fuzzyers/Droid/photos&vids/printing body.jpg

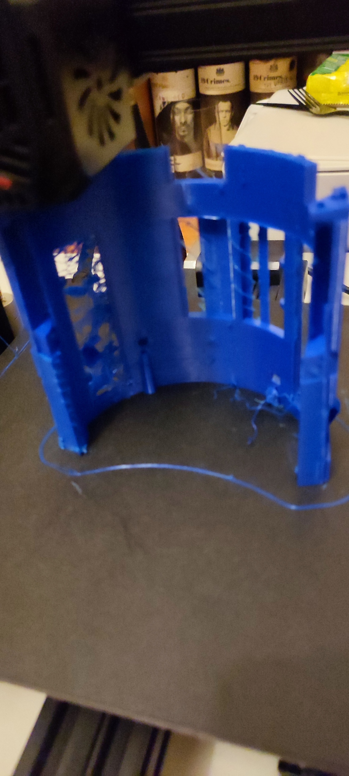
photos&vids/printing body.jpg
