fuzzyers/Droid/photos&vids/HeadTurningSetup.jpg

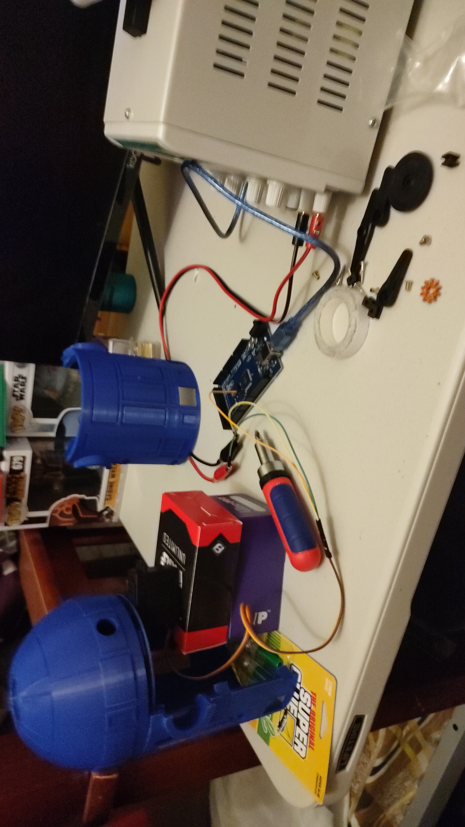
photos&vids/HeadTurningSetup.jpg
