fuzzyers/Droid/README.md

# Droid
Building an Atonmous rolling droid

Extra videos that couldnt upload to github
[https://drive.google.com/drive/u/0/folders/1LiQj8qATu0QSJ6sYIhgVQADvBBUaWfd3
](https://drive.google.com/drive/folders/1LiQj8qATu0QSJ6sYIhgVQADvBBUaWfd3?usp=sharing)
