fuzzyers/Droid/Controller/bottle.jpg

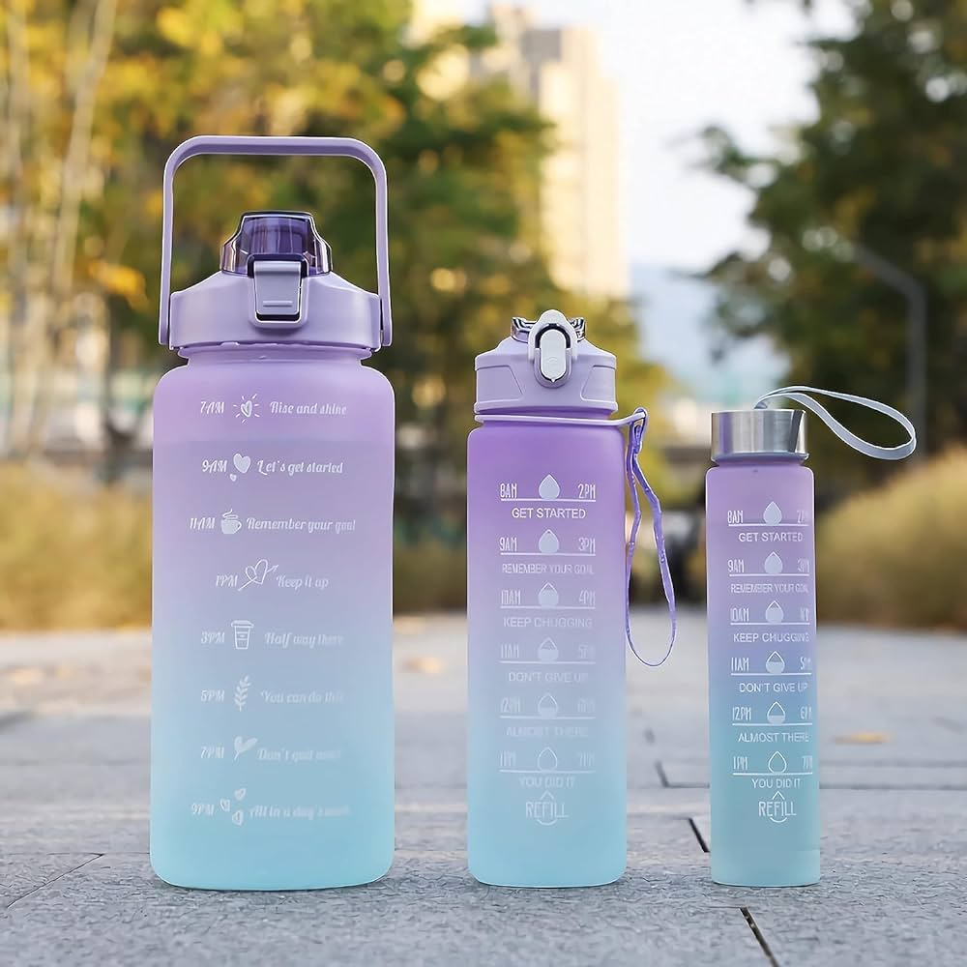
Controller/bottle.jpg
