fuzzyers/Droid/Controller/brad.jpg

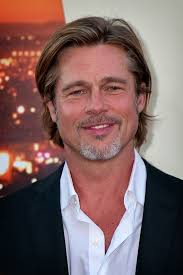
Controller/brad.jpg
