fuzzyers/Droid/Controller/captured_image.jpg

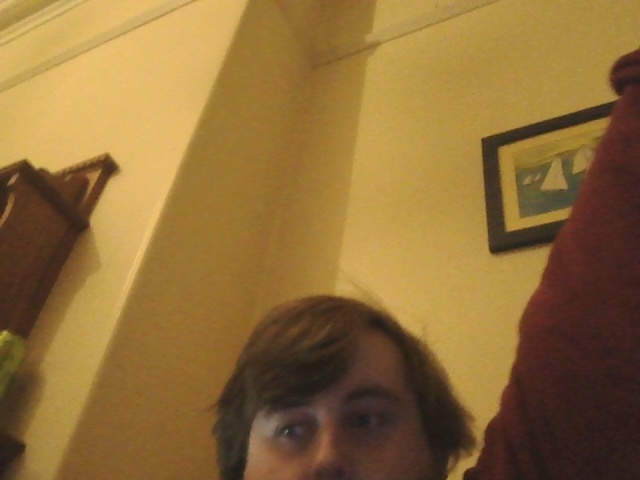
Controller/captured_image.jpg
