fuzzyers/Droid/Controller/depth_map.png

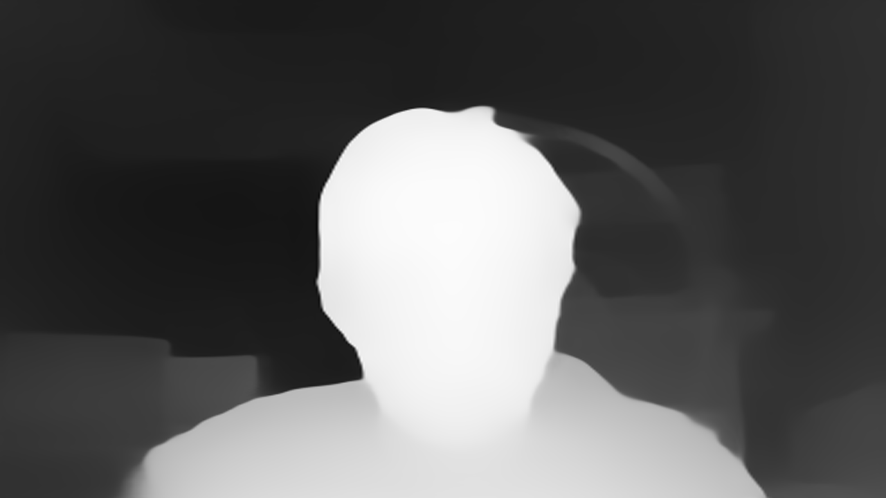
Controller/depth_map.png
