fuzzyers/Droid/Controller/FacialRecognition/me2.jpg

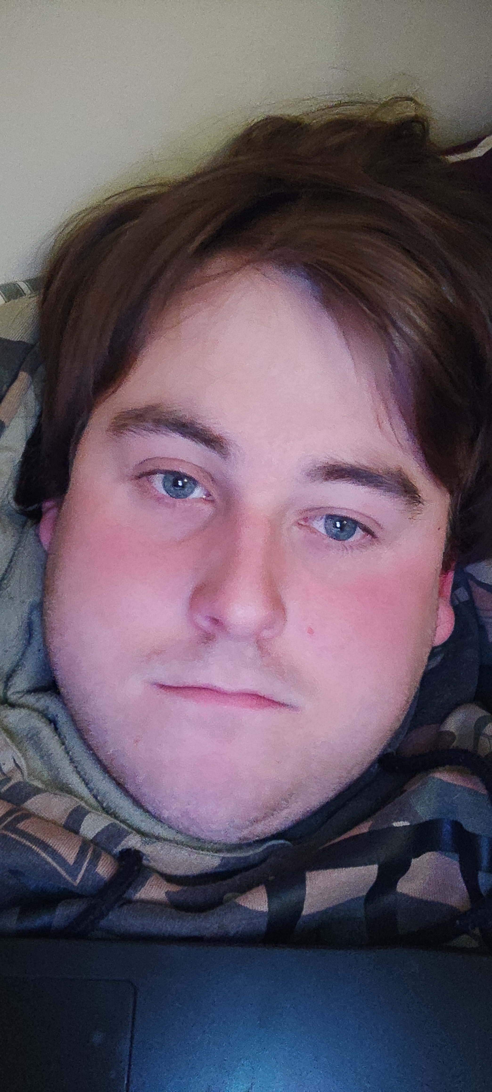
Controller/FacialRecognition/me2.jpg
