fuzzyers/Droid/Controller/FacialRecognition/me3.jpg

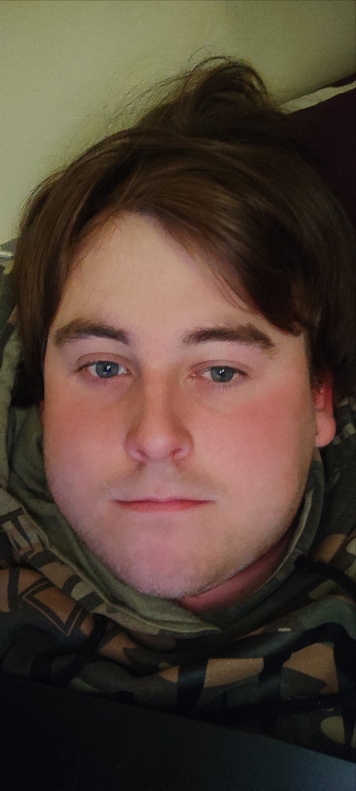
Controller/FacialRecognition/me3.jpg
