fuzzyers/Droid/Controller/FacialRecognition/me4.jpg

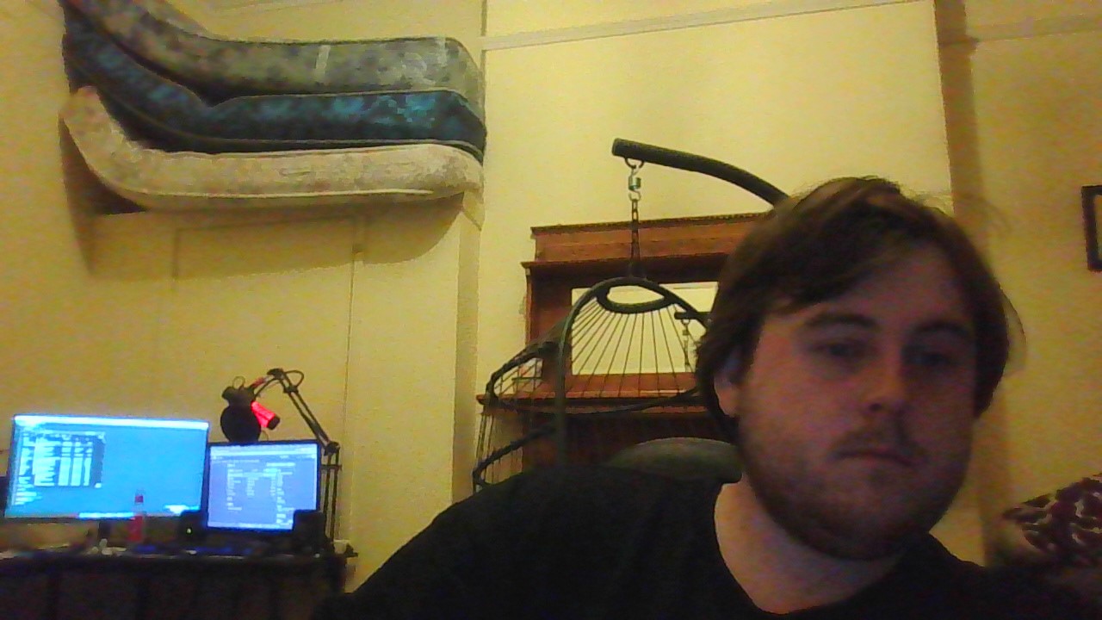
Controller/FacialRecognition/me4.jpg
