fuzzyers/Droid/Controller/FacialRecognition/me5.jpg

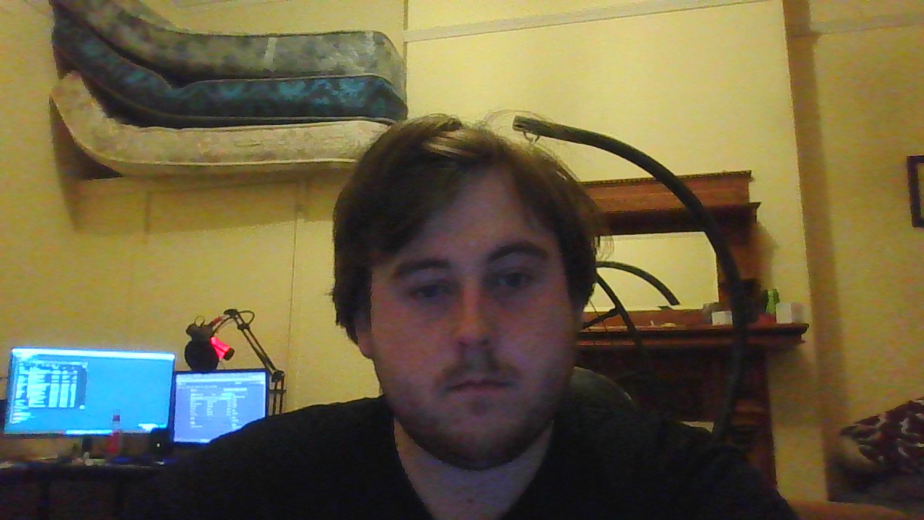
Controller/FacialRecognition/me5.jpg
