fuzzyers/Droid/Controller/FacialRecognition/me6.jpg

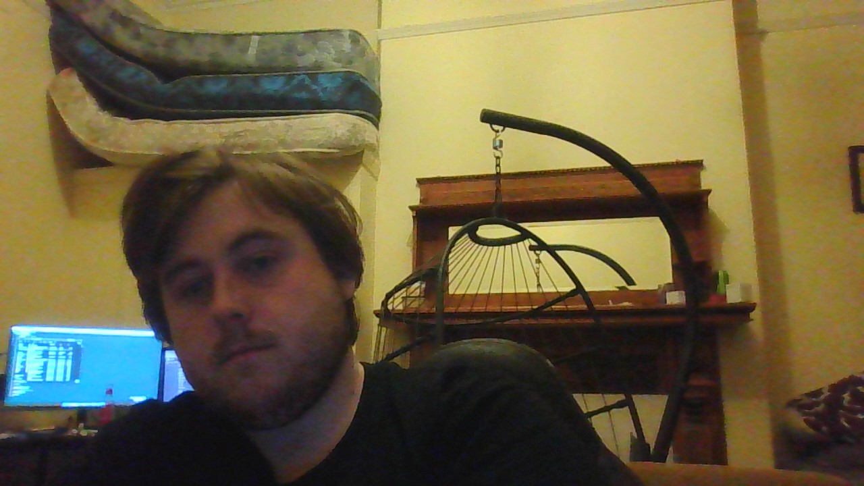
Controller/FacialRecognition/me6.jpg
