fuzzyers/Droid/Controller/group.jpg

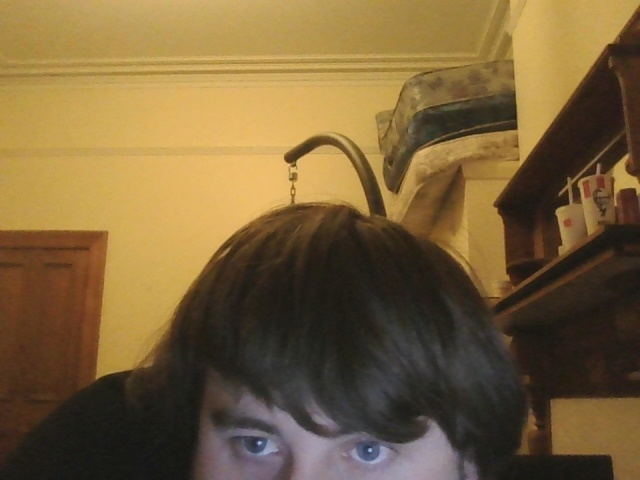
Controller/group.jpg
