fuzzyers/Droid/Controller/me3.jpg

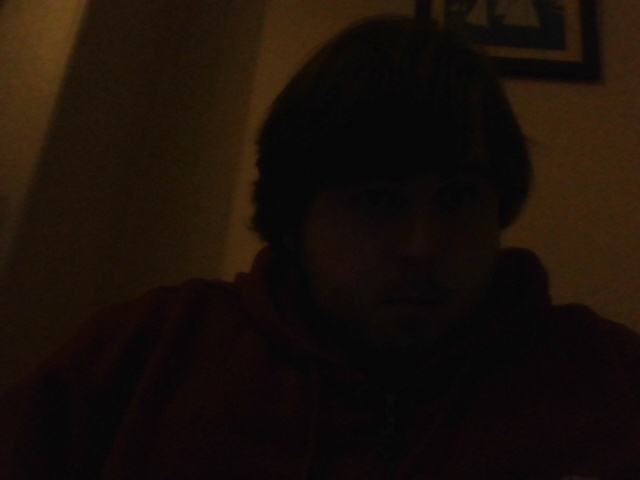
Controller/me3.jpg
