fuzzyers/Droid/Controller/ObjectDetection.png

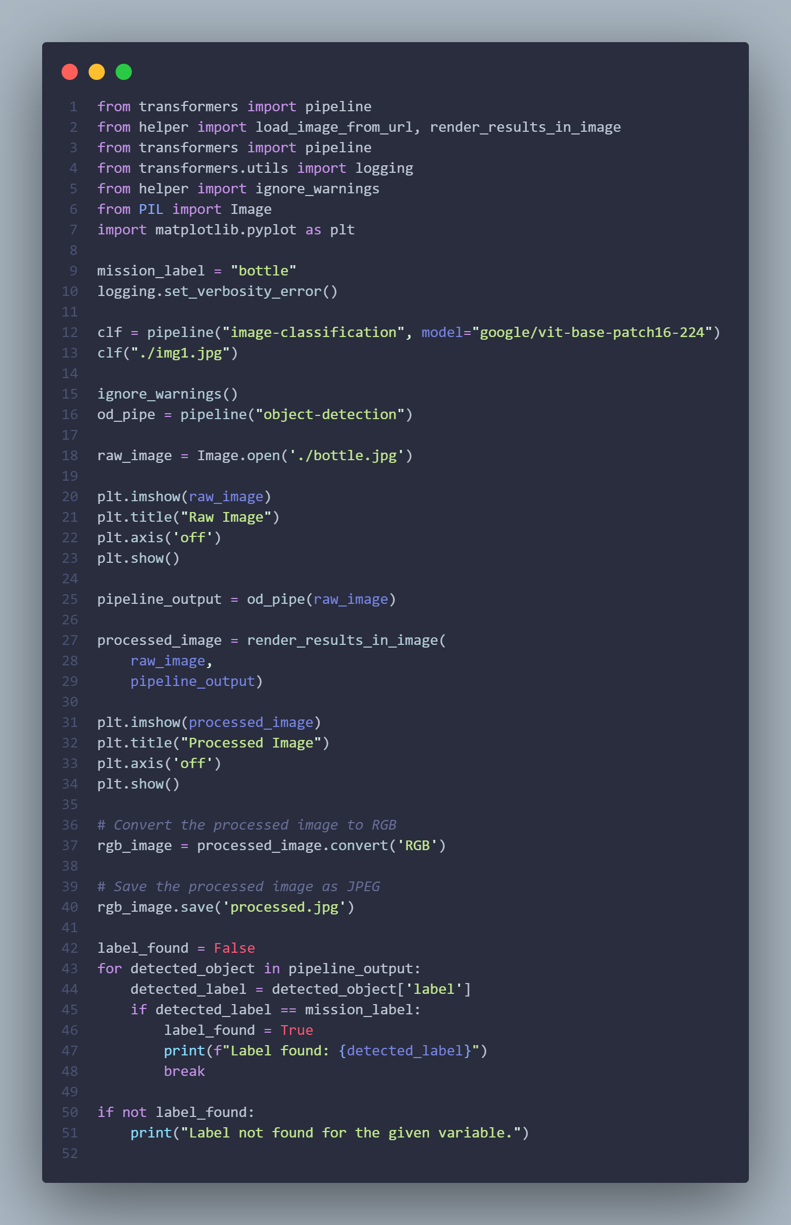
Controller/ObjectDetection.png
