fuzzyers/Droid/Controller/processed.jpg

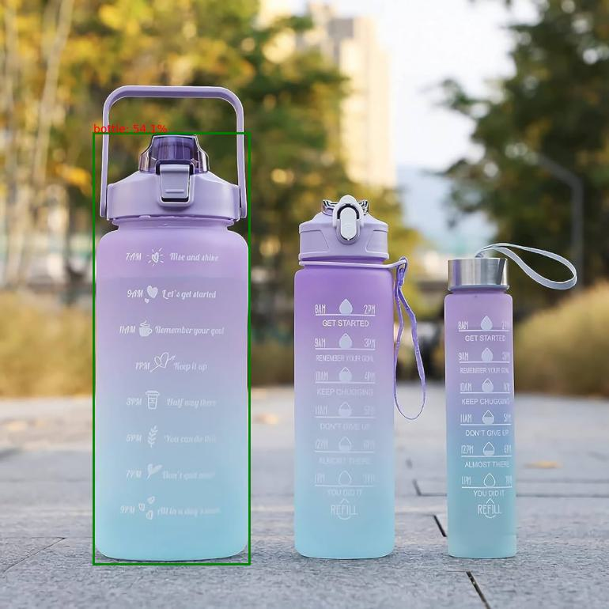
Controller/processed.jpg
