fuzzyers/Droid/Controller/refrence.jpg

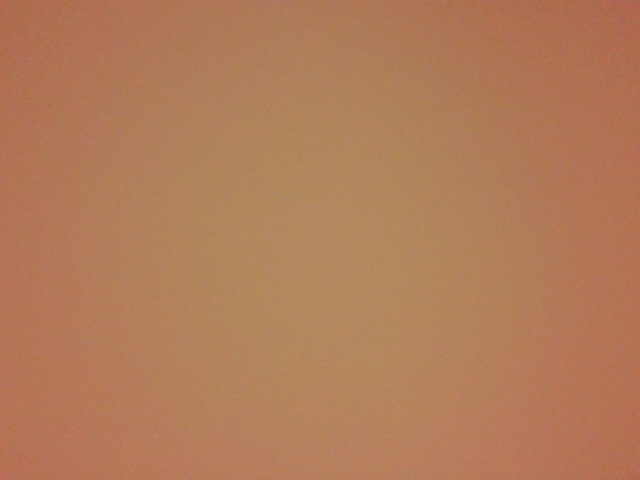
Controller/refrence.jpg
