fuzzyers/Droid/DepthMap/baldwin-street-dunedin.jpg.webp

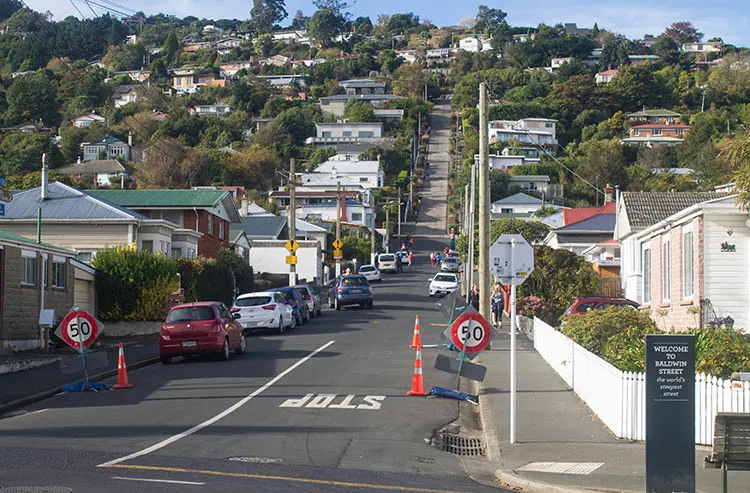
DepthMap/baldwin-street-dunedin.jpg.webp
