fuzzyers/Droid/DepthMap/bolt.jpg

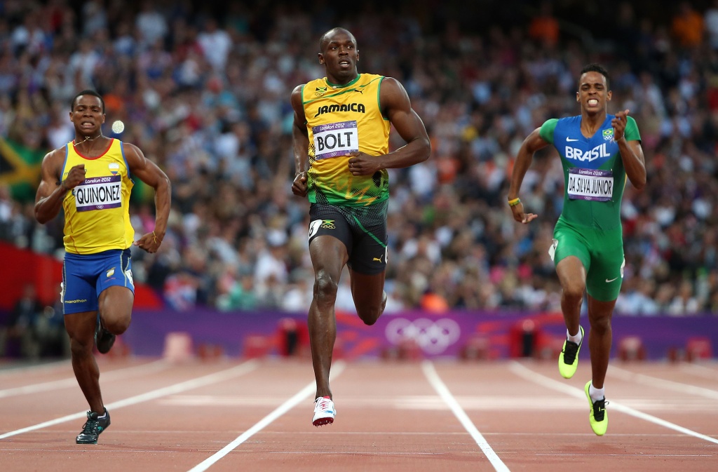
DepthMap/bolt.jpg
