fuzzyers/Droid/DepthMap/depth_map.png

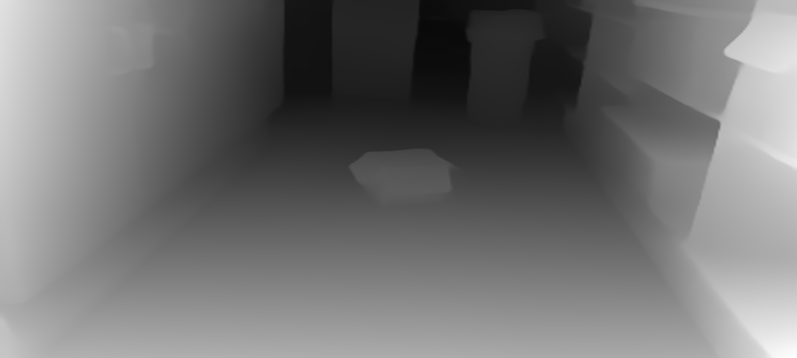
DepthMap/depth_map.png
