fuzzyers/Droid/DepthMap/img2.jpg

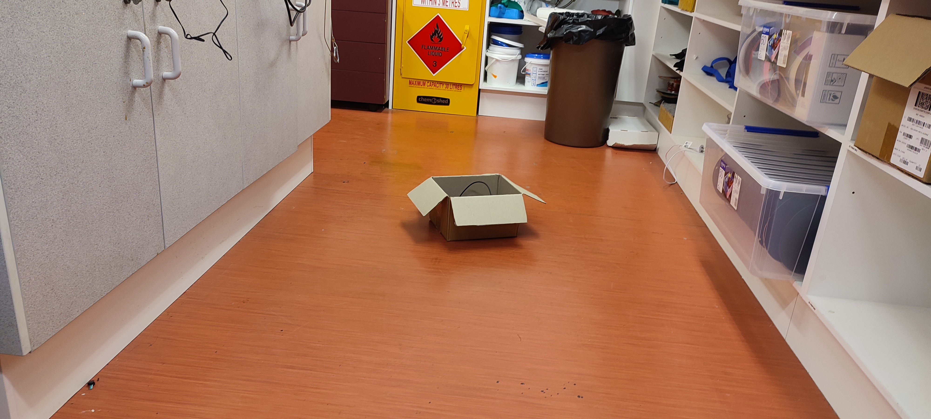
DepthMap/img2.jpg
