fuzzyers/Droid/DepthMap/img3.jpg

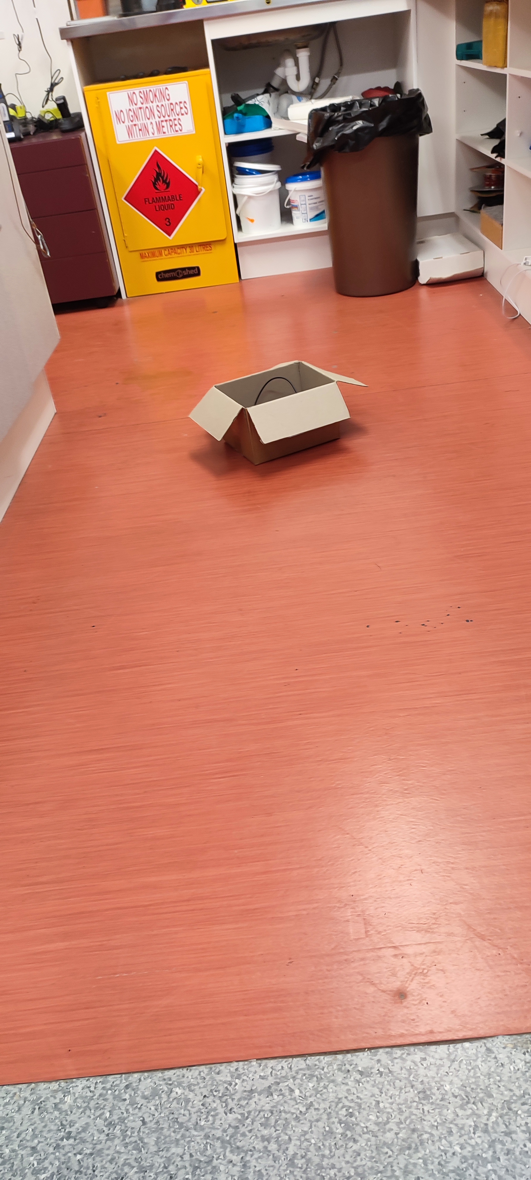
DepthMap/img3.jpg
