fuzzyers/Droid/photos&vids/1719391815629.jpg

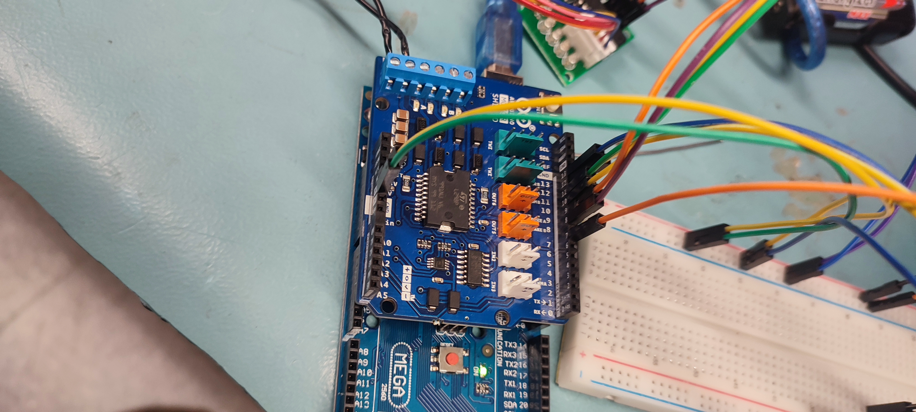
photos&vids/1719391815629.jpg
