fuzzyers/Droid/photos&vids/1719391815665.jpg

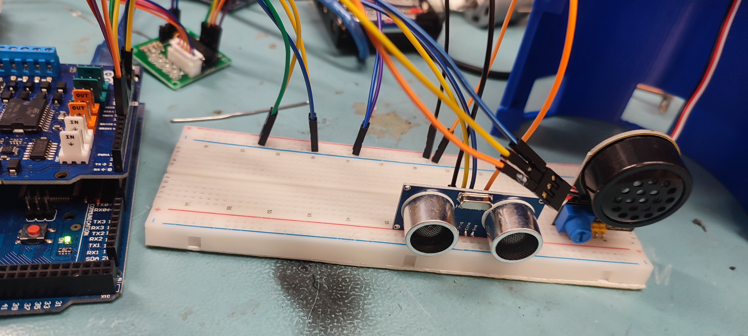
photos&vids/1719391815665.jpg
