fuzzyers/Droid/photos&vids/1719391815684.jpg

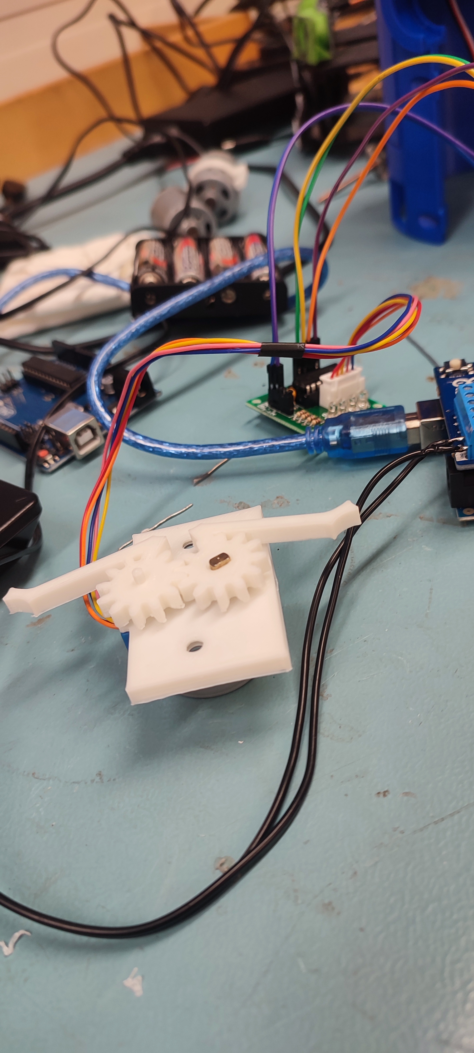
photos&vids/1719391815684.jpg
