fuzzyers/Droid/photos&vids/arduino1.png

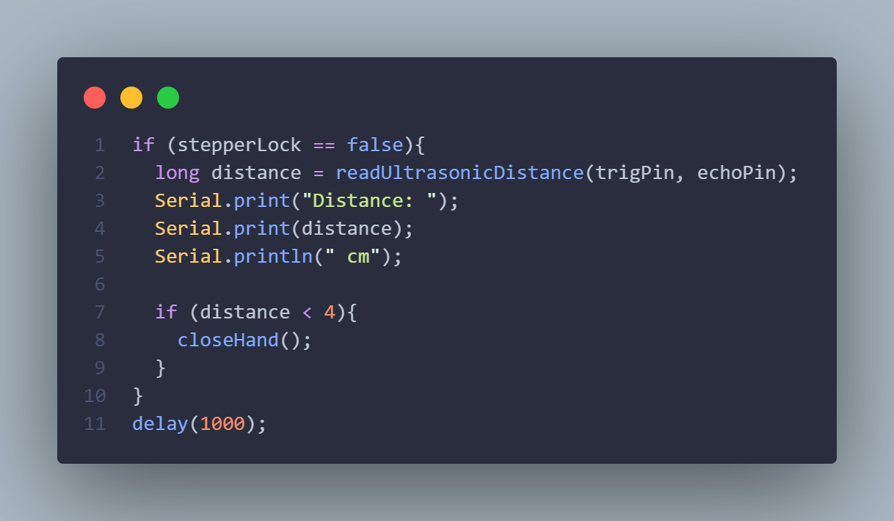
photos&vids/arduino1.png
