fuzzyers/Droid/photos&vids/arduino2.png

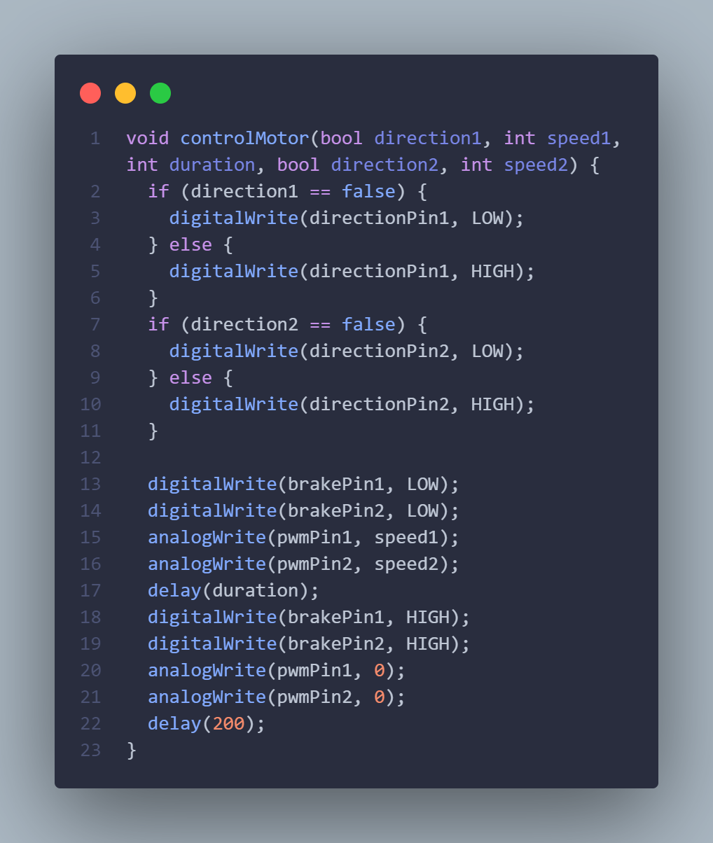
photos&vids/arduino2.png
