fuzzyers/Droid/photos&vids/BodyWithoutHead.jpg

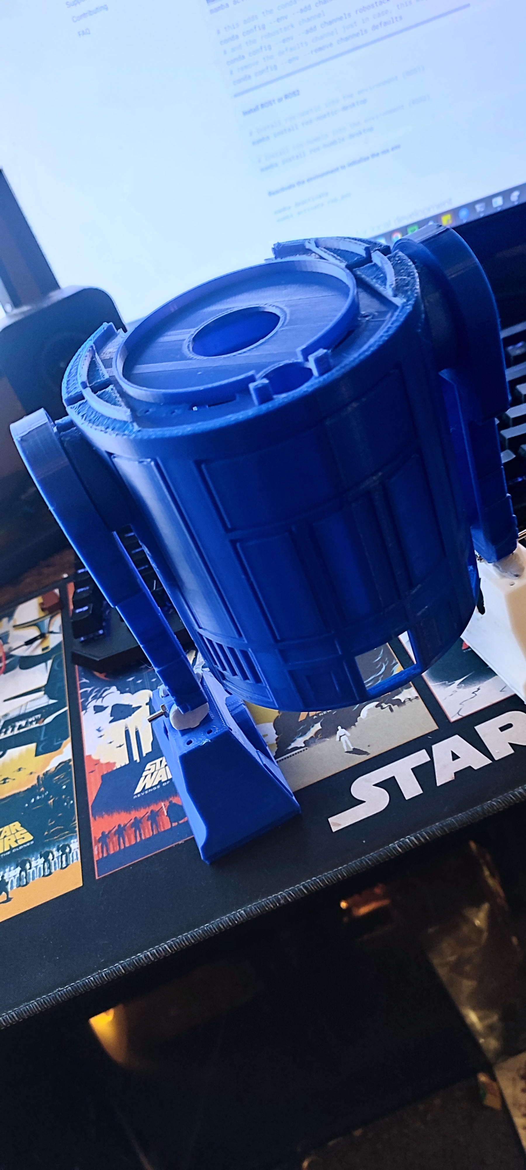
photos&vids/BodyWithoutHead.jpg
