fuzzyers/Droid/photos&vids/ControllerDiagram.jpg

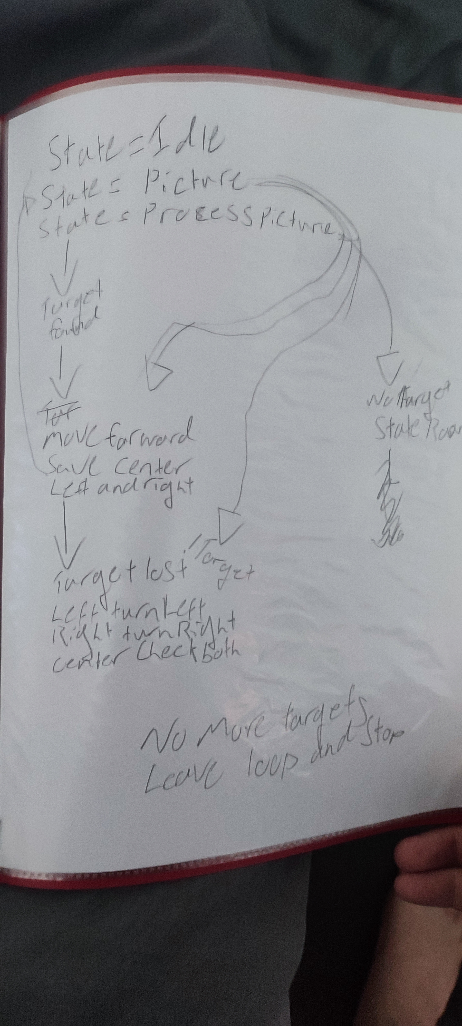
photos&vids/ControllerDiagram.jpg
