fuzzyers/Droid/photos&vids/Hand2.jpg

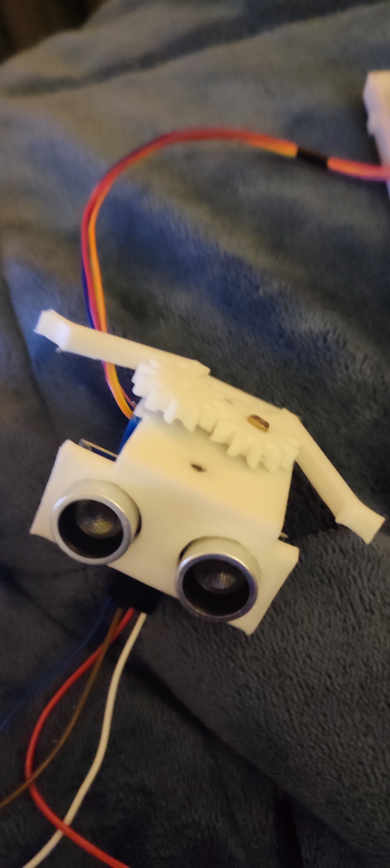
photos&vids/Hand2.jpg
