fuzzyers/Droid/photos&vids/HeadShotsFromFaceialRecognitionAttemptOne.jpg

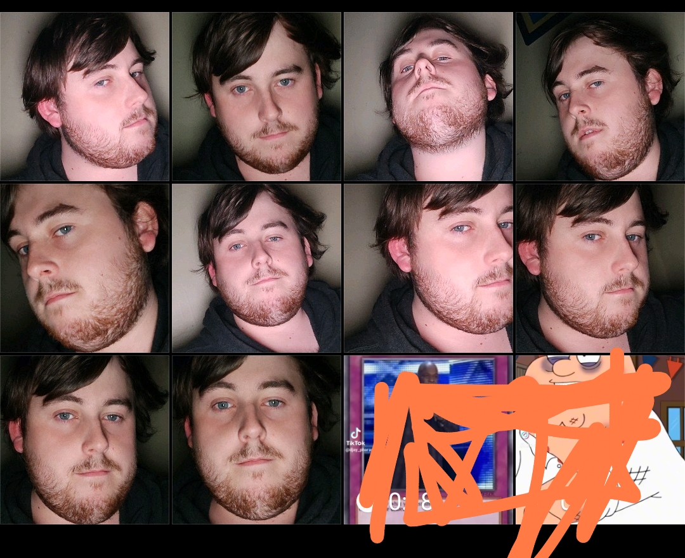
photos&vids/HeadShotsFromFaceialRecognitionAttemptOne.jpg
