fuzzyers/Droid/photos&vids/Ideas.jpg

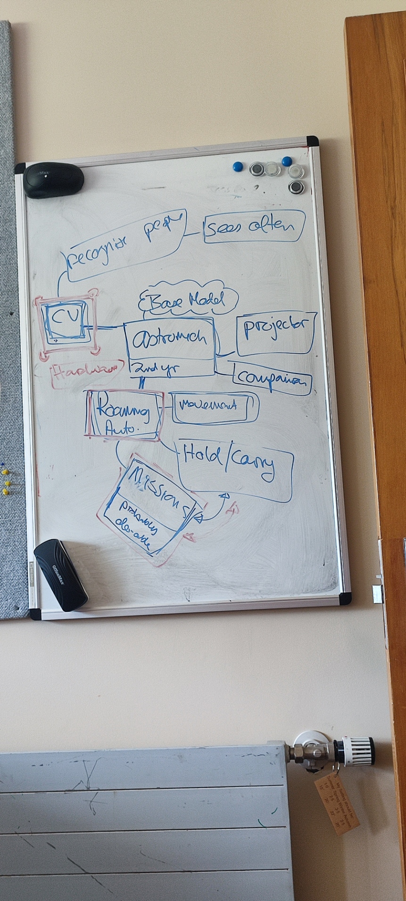
photos&vids/Ideas.jpg
