fuzzyers/Droid/photos&vids/ObjectDetection1.png

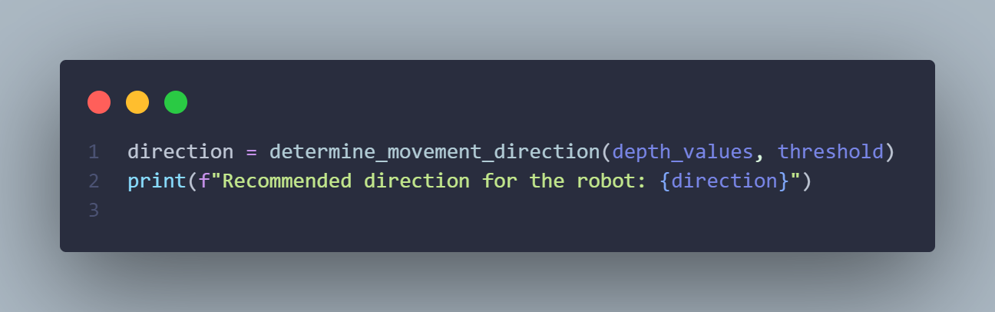
photos&vids/ObjectDetection1.png
