fuzzyers/Droid/photos&vids/WheelV1.jpg

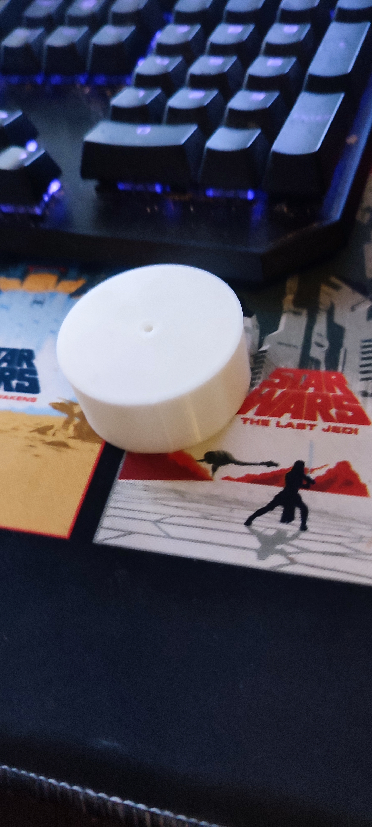
photos&vids/WheelV1.jpg
