fuzzyers/Droid/TensorFlowDetection/img1.jpg

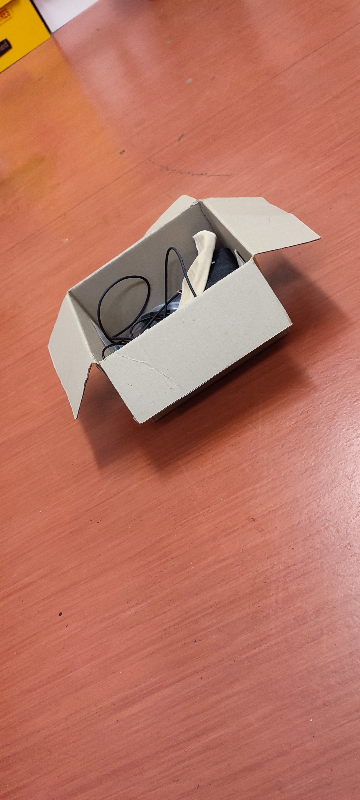
TensorFlowDetection/img1.jpg
