fuzzyers/Droid/TensorFlowDetection/IMG_20240605_111805.jpg

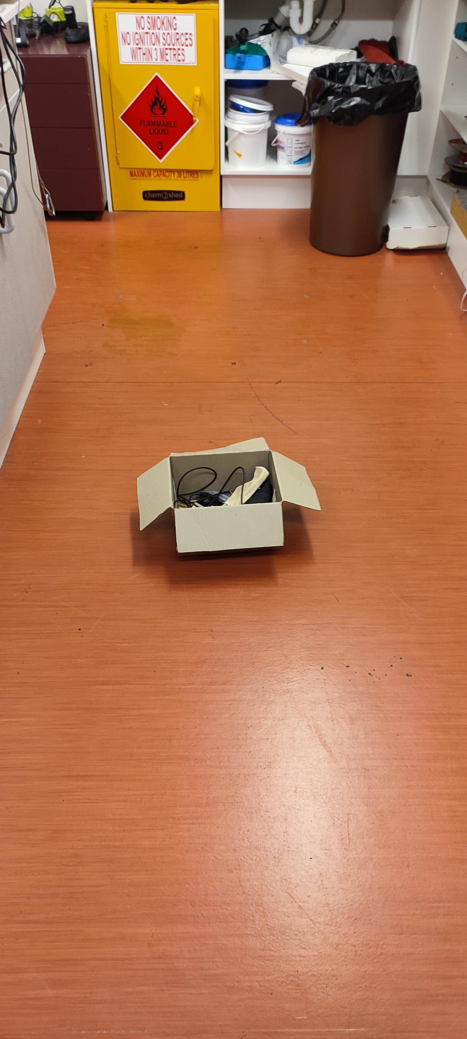
TensorFlowDetection/IMG_20240605_111805.jpg
