fuzzyers/Droid/TensorFlowDetection/IMG_20240605_111808.jpg

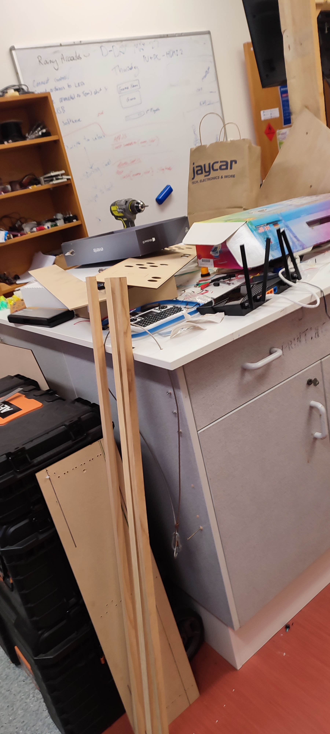
TensorFlowDetection/IMG_20240605_111808.jpg
