fuzzyers/Droid/TensorFlowDetection/me.jpg

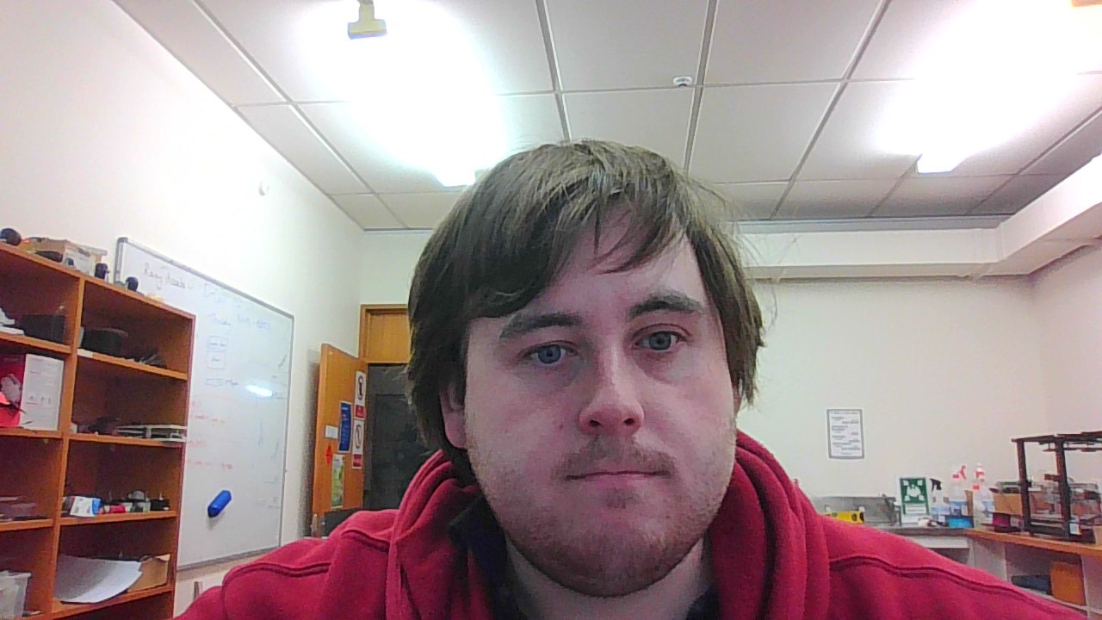
TensorFlowDetection/me.jpg
