fuzzyers/Droid/r2model/dome_projector_grey.stl

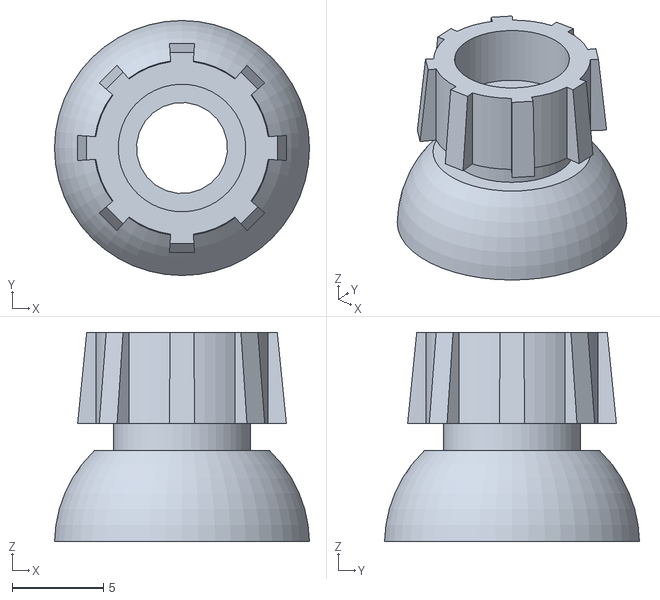
[picture p71: CAD file, 2024-06-11]
r2model/dome_projector_grey.stl
14.0 x 14.0 x 11.5
