fuzzyers/Droid/r2model/gearbox_2.stl

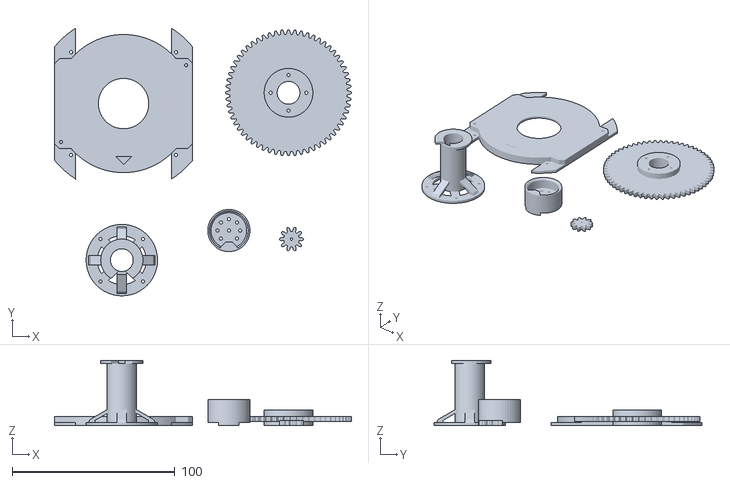
[picture p72: CAD file, 2024-06-11]
r2model/gearbox_2.stl
182.8 x 164.8 x 40.0
