fuzzyers/Droid/r2model/body_parts_blue.stl

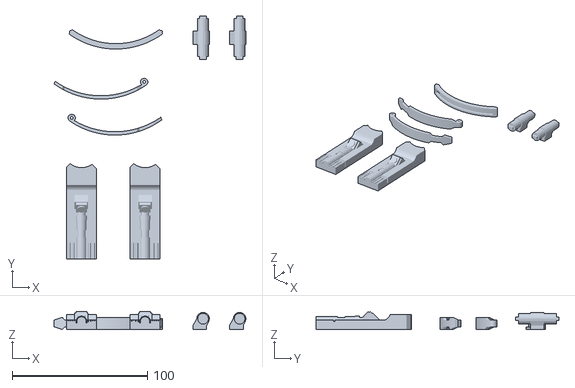
[picture p73: CAD file, 2024-06-11]
r2model/body_parts_blue.stl
141.9 x 179.6 x 13.4
