fuzzyers/Droid/r2model/leg_left_white.stl

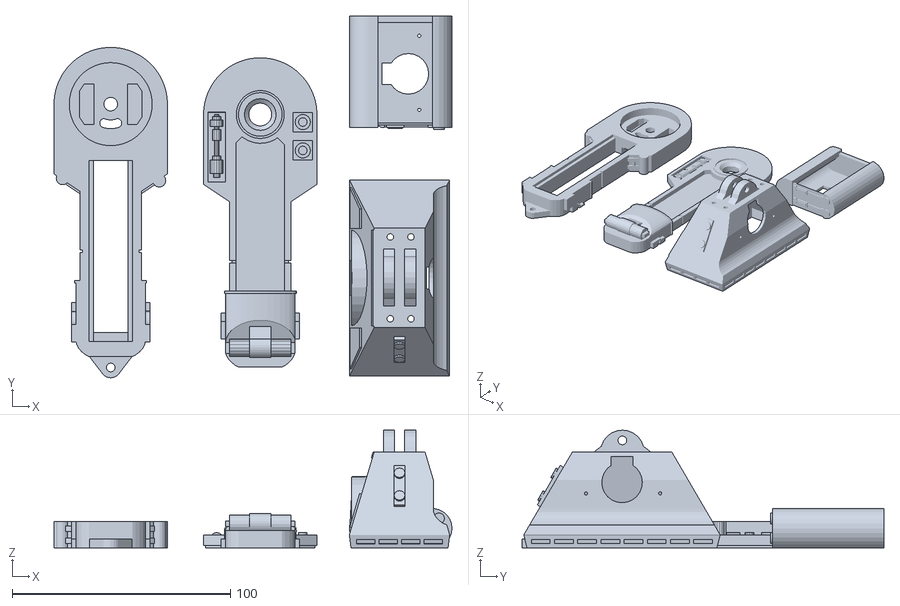
[picture p74: CAD file, 2024-06-11]
r2model/leg_left_white.stl
182.5 x 165.8 x 54.0
