fuzzyers/Droid/r2model/body_utilityarm_blue.stl

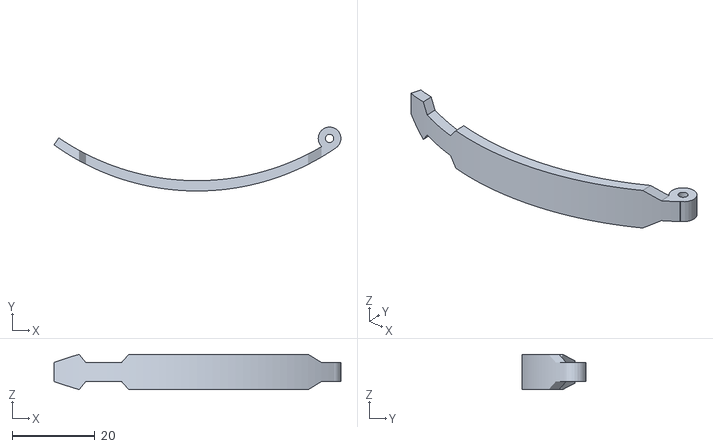
[picture p75: CAD file, 2024-06-11]
r2model/body_utilityarm_blue.stl
69.2 x 15.4 x 8.50
