fuzzyers/Droid/r2model/body_parts_white.stl

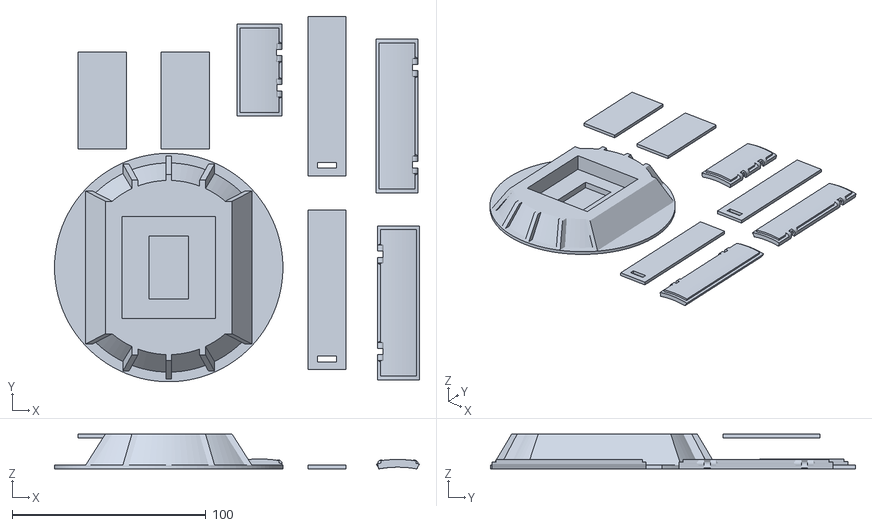
[picture p76: CAD file, 2024-06-11]
r2model/body_parts_white.stl
188.5 x 188.8 x 18.0
