fuzzyers/Droid/r2model/body_white.stl

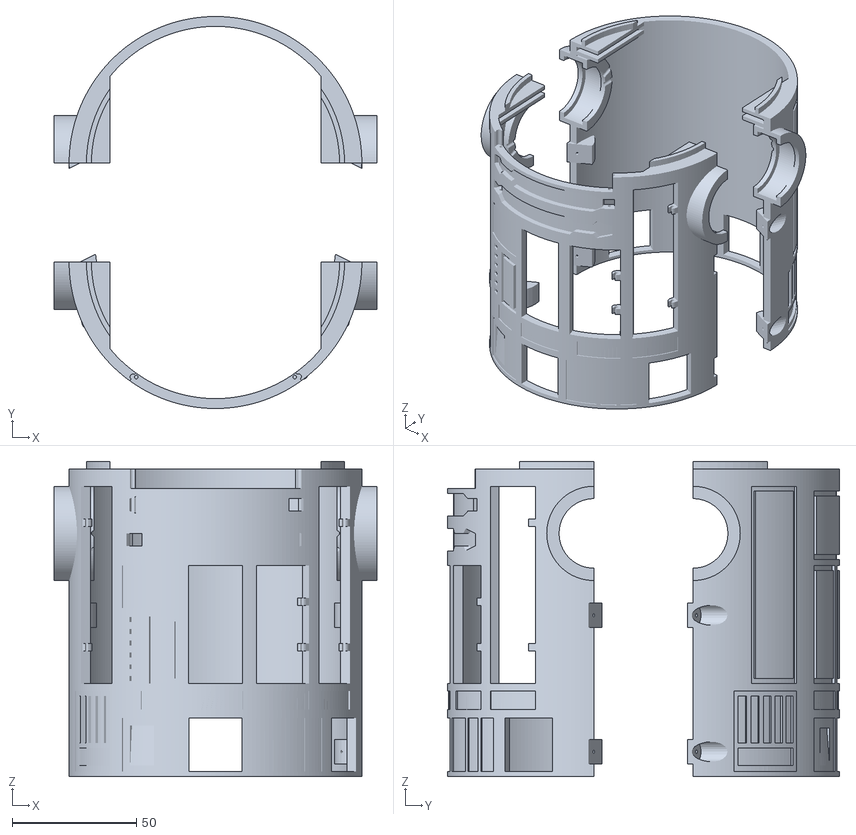
[picture p77: CAD file, 2024-06-11]
r2model/body_white.stl
130.0 x 158.0 x 127.0
