fuzzyers/Droid/r2model/dome_bodyparts_grey.stl

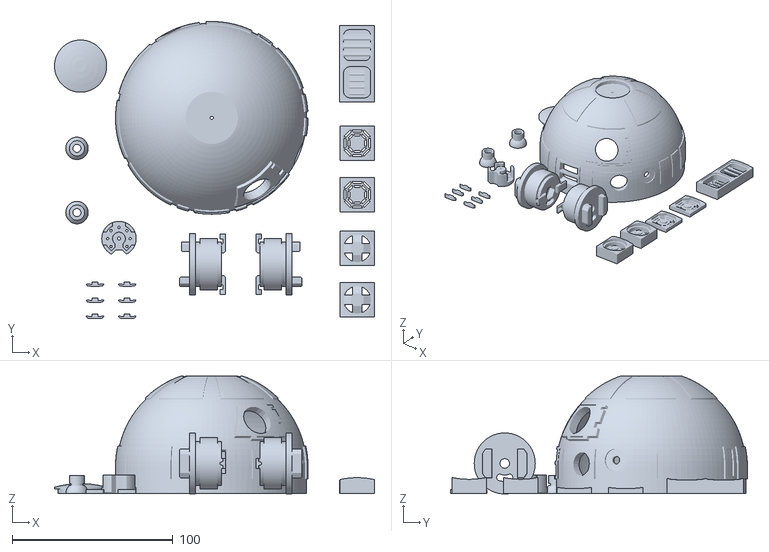
[picture p78: CAD file, 2024-06-11]
r2model/dome_bodyparts_grey.stl
199.2 x 184.9 x 73.4
