fuzzyers/Droid/r2model/r2d2_skirt_batt.stl

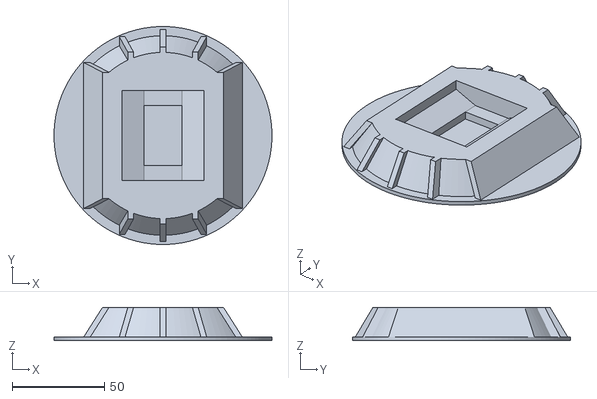
[picture p79: CAD file, 2024-06-11]
r2model/r2d2_skirt_batt.stl
118.0 x 118.0 x 18.0
