fuzzyers/Droid/r2model/r2d2_skirt.stl

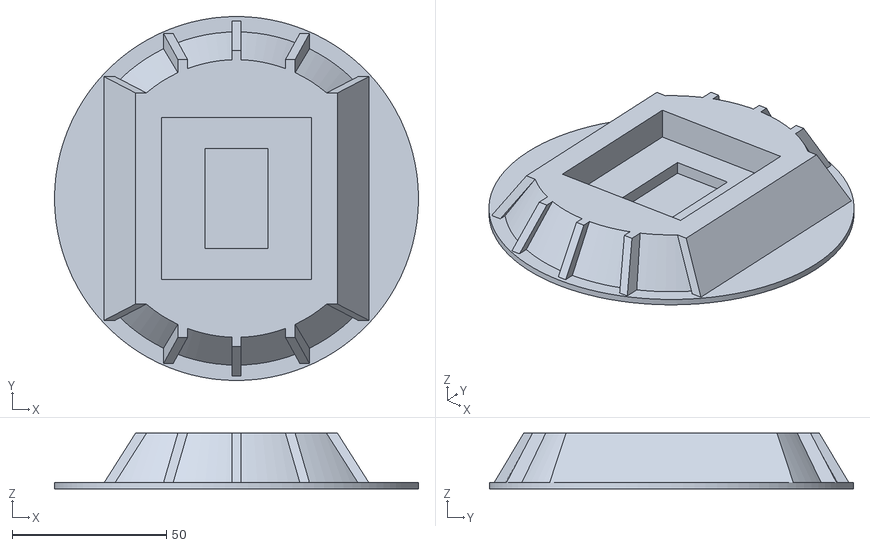
[picture p80: CAD file, 2024-06-11]
r2model/r2d2_skirt.stl
118.0 x 118.0 x 18.0
