fuzzyers/Droid/r2model/leg_right_white.stl

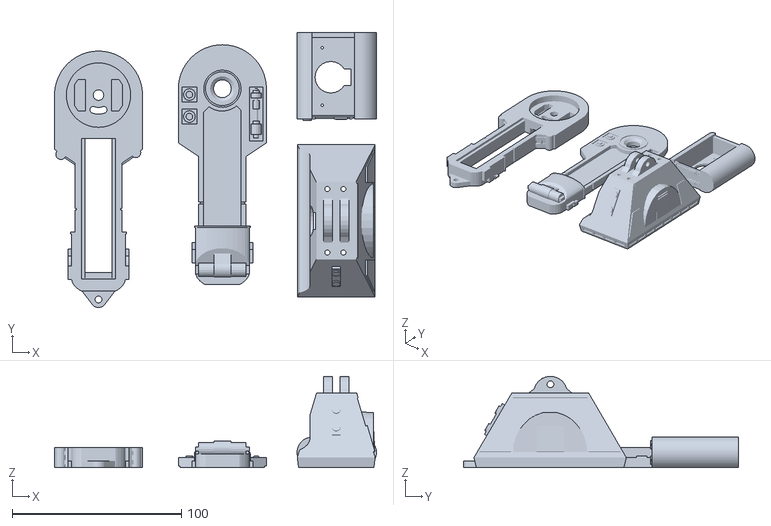
[picture p81: CAD file, 2024-06-11]
r2model/leg_right_white.stl
190.2 x 162.5 x 54.0
