fuzzyers/Droid/r2model/gearbox_1.stl

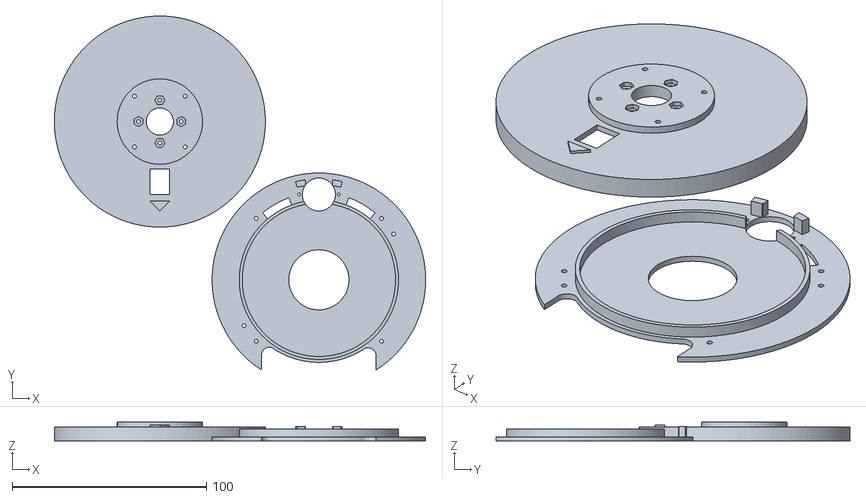
[picture p82: CAD file, 2024-06-11]
r2model/gearbox_1.stl
191.3 x 182.3 x 9.60
