fuzzyers/Droid/photos&vids/Echo Sensor Testing Wiring.jpg

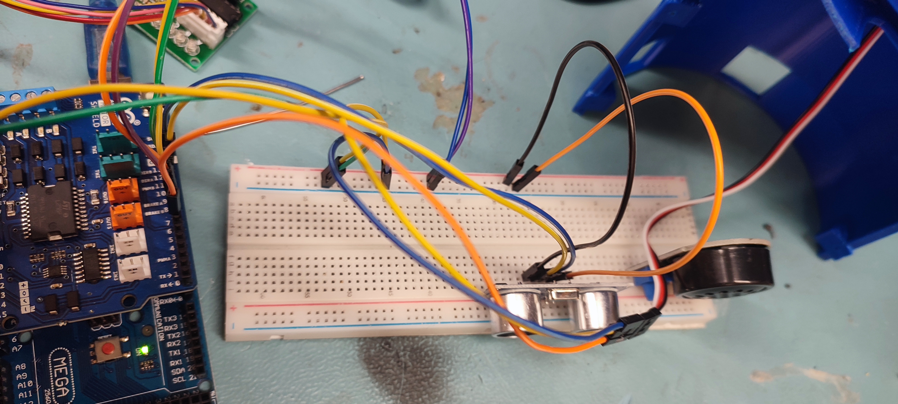
photos&vids/Echo Sensor Testing Wiring.jpg
