fuzzyers/Droid/photos&vids/Installing Packages on Pi.jpg

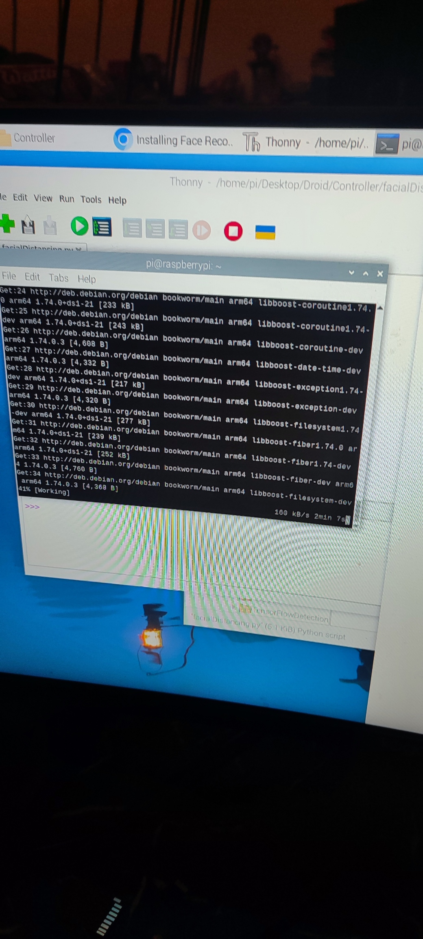
photos&vids/Installing Packages on Pi.jpg
