fuzzyers/Droid/photos&vids/Raspberry Pi Package indvidual Package installation for DLIB Library.jpg

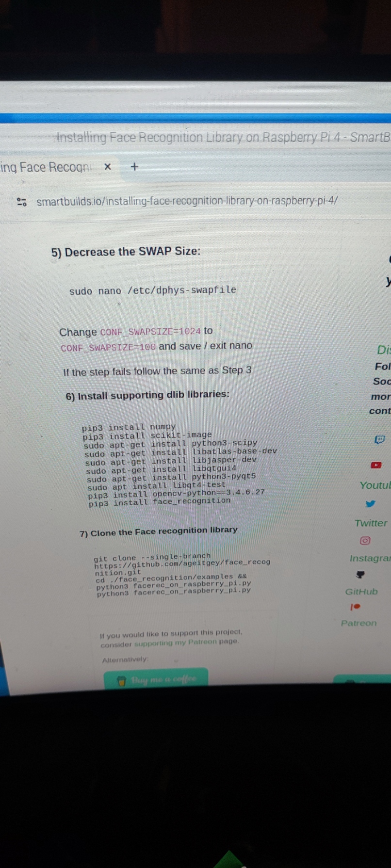
photos&vids/Raspberry Pi Package indvidual Package installation for DLIB Library.jpg
