fuzzyers/Droid/photos&vids/Raspberry Pi Package indvidual Package installation for FaceRcognition Library.jpg

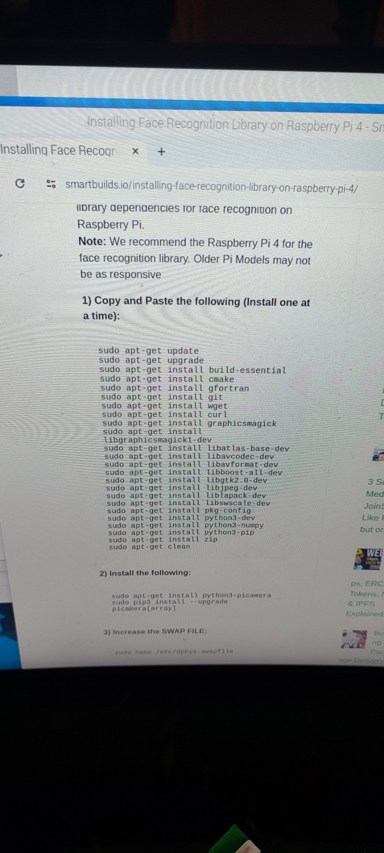
photos&vids/Raspberry Pi Package indvidual Package installation for FaceRcognition Library.jpg
