fuzzyers/Droid/photos&vids/testing on raspberry pi.jpg

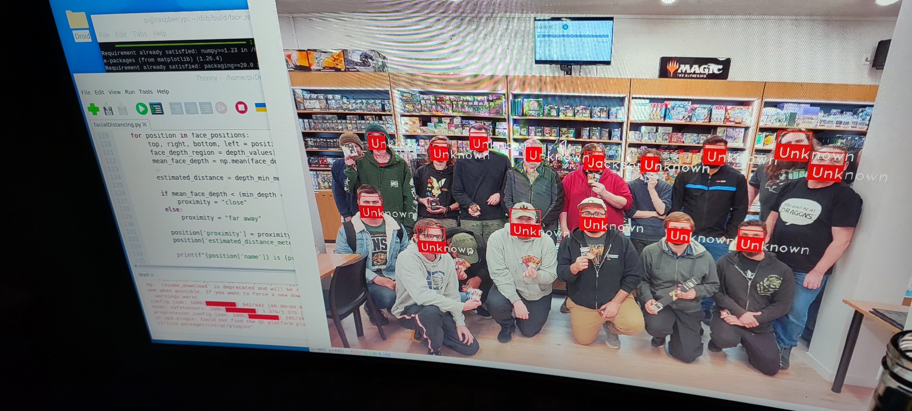
photos&vids/testing on raspberry pi.jpg
