fuzzyers/Droid/(threads)

Thread 3 (2024-03-12):

Computer Vision [Obstacles]

fuzzyers, 2024-03-12:
The main sensor of the robot to help it see its way round will be a camera such as a pi camera.
Using computer vision it will be trained to recognise obstacles and to avoid them.

Thread 5 (2024-06-12):

Controller

fuzzyers, 2024-06-12:
- The controllers current state is it reads and sends serial to an arduino.
- It currently takes a snap with the webcam
- It will execute the facial recognition script which will use the newly taken photo

- It will need the other scripts added
- Object Recognition
- Depth Mapping
