fuzzyers/Droid/(commit log)

2024-06-11 Current Progress On depth Map
2024-06-11 Add files via upload
    Allows Motor Shield to use 2 motors
2024-06-11 Controller Currently Takes Photos and Runs Facial Recognition Script
2024-06-11 ALl images i am working with
    [body_parts_blue.stl, body_parts_white.stl, body_utilityarm_blue.stl, body_white.stl, dome_bodyparts_grey.stl, dome_projector_grey.stl, gearbox_1.stl, gearbox_2.stl]
2024-06-11 Added Test USB I2C Comunication to it
2024-06-11 Added Basic Master I2C Communication to arduino
2024-06-14 updated code
    [body_parts_blue.stl, body_parts_white.stl, body_utilityarm_blue.stl, body_white.stl, dome_bodyparts_grey.stl, dome_projector_grey.stl, gearbox_1.stl, gearbox_2.stl]
2024-06-20 Updated Controller for Arduino and Python
2024-06-25 Added LaunchScript on Button press and Made tweaks to Controller.py
